RichardBoy05/Smart-Parking-City/README [ITA].md

# Smart Parking City 🚗
Prototipo di un sistema di parcheggio intelligente implementato a livello comunale, il cui obiettivo è dimostrare come l’introduzione di **dispositivi IoT** (_Internet of Things_) possa agevolare la vita delle persone.

## Indice
1. [Il mondo dell'IoT](#il-mondo-delliot)
2. [Panoramica del progetto](#panoramica-del-progetto)
3. [Materiali](#materiali)
4. [Circuito](#circuito)
5. [Adattamenti e conversioni dei parametri](#bugs)
6. [Licenza](#licenza)
7. [Domande, suggerimenti e bug fixes](#domande-suggerimenti-e-bug-fixes)

## Il mondo dell'IoT
### "Un mondo interconnesso"
Il mondo sta assistendo ad una rapida diffusione delle reti digitali, che consentono ai dispositivi di connettersi e trasmettere informazioni. Questo fenomeno, noto come ***trasformazione digitale***, consiste nell’applicazione della tecnologia digitale al fine di stimolare innovazione ed progresso.
I **sensori** sono ovunque ormai: grazie ad essi è possibile raccogliere una grande quantità di dati che possono essere archiviati, analizzati e utilizzati per una moltitudine di scopi differenti, come monitorare l'ambiente, prevedere la crescita demografica, gestire i rifiuti, migliorare la sicurezza domestica, e molti altri.

**Curiosità** 💡: La diffusione di processori economici e reti wireless ha facilitato la diffusione dei dispositivi IoT. Si prevede che entro il 2025 ci saranno 38,6 miliardi di dispositivi connessi a Internet, aumentando a 50 miliardi entro il 2030, con una media di 190 milioni di nuovi dispositivi ogni mese.

Un mondo sempre più "interconnesso"...

### Internet of Things
#### Cosa s'intende per IoT?
> **“Internet of Things” (IoT) è una rete interconnessa di dispositivi fisici (things), che comunicano e scambiano dati per migliorare l'efficienza e l'esperienza umana in svariati settori, tramite l’utilizzo di sensori ed altre tecnologie.**

#### Quali caratteristiche deve possedere un oggetto IoT?
- **Connettività:** capacità di connettersi in modo affidabile a reti, tramite tecnologie e protocolli di comunicazione efficaci.
- **Sensori e attuatori**: capacità di percepire l’ambiente attraverso sensori e di agire su di esso tramite attuatori; questa funzionalità consente al dispositivo di raccogliere dati, prendere decisioni basate su tali dati e potenzialmente influenzare l'ambiente circostante.
- **Automazione:** implementare processi autogestiti che riducono, per poi eventualmente eliminare, la necessità dell’intervento umano; l’IoT apre un nuovo mondo in cui le attività che prima richiedevano l’intervento umano possono diventare automatizzate**.**
- **Scalabilità:** dato che gli ambienti IoT possono variare notevolmente in termini di dimensioni e complessità, i dispositivi dovrebbero essere progettati per scalare facilmente in modo da poter essere utilizzati in piccole reti domestiche o in grandi reti industriali.
- **Sicurezza:** l'integrità e la sicurezza dei dati sono cruciali nell'ambito dell'IoT, specialmente quando si tratta di gestire informazioni sensibili.
- **Interoperabilità:** capacità di interagire con altri dispositivi e sistemi, essenziale per consentire una comunicazione efficace tra dispositivi di diversi produttori e piattaforme.
- **Efficienza energetica:** molti dispositivi IoT sono alimentati da batterie o sorgenti di energia limitate; l'efficienza energetica è un aspetto chiave per garantire una lunga durata della batteria e ridurre l'impatto ambientale.
- **Manutenzione remota e aggiornamenti:** essenziale per garantire che i dispositivi IoT rimangano sicuri e aggiornati nel tempo.
