RichardBoy05/Smart-Parking-City/resources/map/cartelli_stradali.png

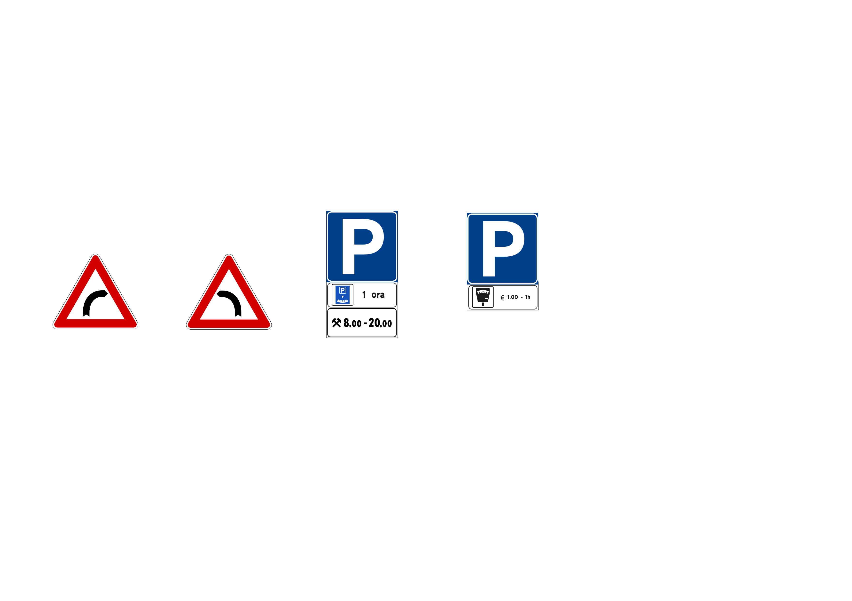
resources/map/cartelli_stradali.png
