RichardBoy05/Smart-Parking-City/resources/map/solar_panel.png

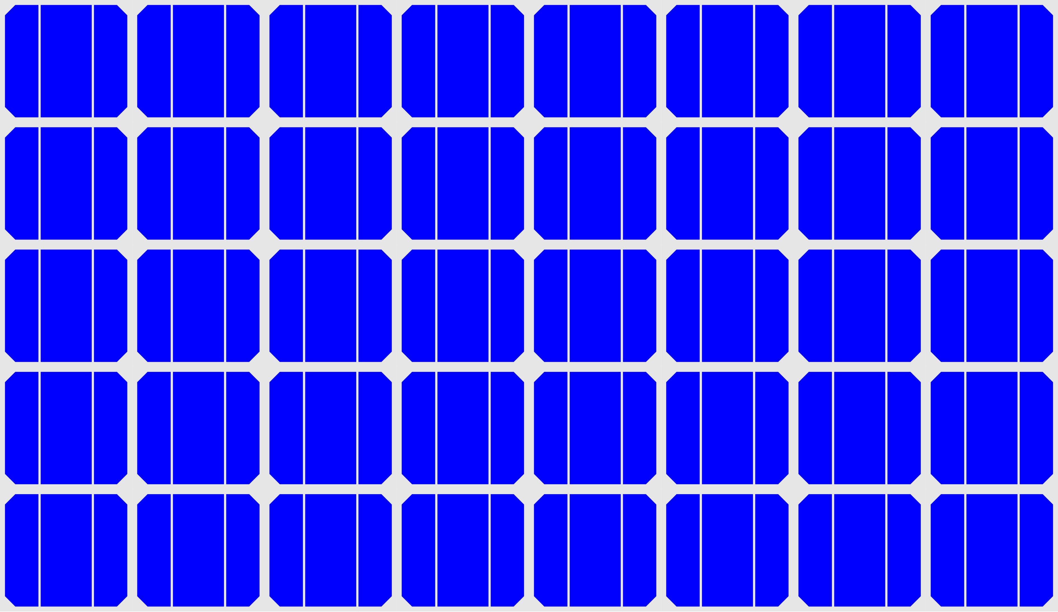
resources/map/solar_panel.png
