RichardBoy05/Smart-Parking-City/(threads)

Thread 1 (2024-07-02):

Interferenza nei sensori ad infrarossi

RichardBoy05, 2024-07-02:
I sensori a infrarossi, quando esposti a un'eccessiva luce ambientale, rimanevano costantemente attivi anche in assenza di oggetti di fronte a loro. Di conseguenza, ho dovuto sostituirli con due sensori a ultrasuoni. Nella presentazione non ho riportato le minime modifiche apportate a seguito della sostituzione, al fine di conservare una memoria del progetto nella sua forma originale. Tuttavia, il problema è stato **risolto**.

Closed 2024-07-02.
