RichardBoy05/Smart-Parking-City/src/LedMatrixConfig.h

/*
 *
 * This sketch defines 4 matrices representing different visual states for a graphical display.
 * These matrices are meant to be displayed on the Arduino UNO R4 WiFi built-in LED matrix.
 * Note: the images in the code are designed to appear upside down for optimal visualization on the board.
 *
 */


// normal code flow (heart shape)
byte running_matrix[8][12] = {
  { 0, 0, 0, 0, 0, 0, 0, 0, 0, 0, 0, 0 },
  { 0, 0, 0, 0, 0, 1, 0, 0, 0, 0, 0, 0 },
  { 0, 0, 0, 0, 1, 0, 1, 0, 0, 0, 0, 0 },
  { 0, 0, 0, 1, 0, 0, 0, 1, 0, 0, 0, 0 },
  { 0, 0, 1, 0, 0, 0, 0, 0, 1, 0, 0, 0 },
  { 0, 1, 0, 0, 0, 1, 0, 0, 0, 1, 0, 0 },
  { 0, 1, 0, 0, 1, 0, 1, 0, 0, 1, 0, 0 },
  { 0, 0, 1, 1, 0, 0, 0, 1, 1, 0, 0, 0 }
};

// setup process in progress (hourglass shape)
byte setup_matrix[8][12] = {
  { 0, 0, 0, 1, 1, 1, 1, 1, 1, 0, 0, 0 },
  { 0, 0, 0, 1, 0, 0, 0, 0, 1, 0, 0, 0 },
  { 0, 0, 0, 1, 0, 0, 0, 0, 1, 0, 0, 0 },
  { 0, 0, 0, 0, 1, 0, 0, 1, 0, 0, 0, 0 },
  { 0, 0, 0, 0, 1, 0, 0, 1, 0, 0, 0, 0 },
  { 0, 0, 0, 1, 0, 0, 0, 0, 1, 0, 0, 0 },
  { 0, 0, 0, 1, 0, 0, 0, 0, 1, 0, 0, 0 },
  { 0, 0, 0, 1, 1, 1, 1, 1, 1, 0, 0, 0 }
};

// connection lost, attempting to reconnect (WiFi symbol)
byte attempting_reconnection_matrix[8][12] = {
  { 0, 0, 0, 0, 0, 1, 1, 0, 0, 0, 0, 0 },
  { 0, 0, 0, 0, 1, 0, 0, 1, 0, 0, 0, 0 },
  { 0, 0, 1, 0, 0, 1, 1, 0, 0, 1, 0, 0 },
  { 0, 0, 0, 1, 0, 0, 0, 0, 1, 0, 0, 0 },
  { 0, 1, 0, 0, 1, 1, 1, 1, 0, 0, 1, 0 },
  { 0, 0, 1, 0, 0, 0, 0, 0, 0, 1, 0, 0 },
  { 0, 0, 0, 1, 1, 1, 1, 1, 1, 0, 0, 0 },
  { 0, 0, 0, 0, 0, 0, 0, 0, 0, 0, 0, 0 }
};

// inability to establish a network connection (dead face)
byte no_connection_matrix[8][12] = {
  { 0, 0, 0, 0, 0, 0, 0, 0, 0, 0, 0, 0 },
  { 0, 0, 0, 1, 0, 0, 0, 0, 1, 0, 0, 0 },
  { 0, 0, 0, 0, 1, 1, 1, 1, 0, 0, 0, 0 },
  { 0, 0, 0, 0, 0, 0, 0, 0, 0, 0, 0, 0 },
  { 0, 0, 1, 0, 1, 0, 0, 1, 0, 1, 0, 0 },
  { 0, 0, 0, 1, 0, 0, 0, 0, 1, 0, 0, 0 },
  { 0, 0, 1, 0, 1, 0, 0, 1, 0, 1, 0, 0 },
  { 0, 0, 0, 0, 0, 0, 0, 0, 0, 0, 0, 0 }
};
